akashgund/Handsfree-Computer-Assist/readme

This project is a IEEE accepted project.
The system was designed to help paralyzed computer and was accomplished with help of team work from along with two other colleagues -Bronson Mendonca and Siddhant Reddy
The material keyboard application was made with QT framework which is one the best ways to make cross platform applications.
The arduino code is designed for arduino leonardo.
