akashgund/Handsfree-Computer-Assist/Final report/BLACKBOOK1 (1).pdf

## PROJECT REPORT

ON

## COMPUTER ASSIST FOR PARALYZED USING EEG

SUBMITTED TO THE

## UNIVERSITY OF MUMBAI

FOR THE DEGREE OF

## BACHELOR OF ENGINEERING

IN

## COMPUTER ENGINEERING 2016-2017

Submitted by

Akash Gund (Roll No.24)

Bronson Mendonca (Roll No.45)

Siddhant Reddy (Roll No.58)

Supervisors:

Mrs. Kalpita Wagaskar

Mrs. Sejal Chopra

### DEPARTMENT OF COMPUTER ENGINEERING

DON BOSCO INSTITUTE OF TECHNOLOGY (ENGINEERING COLLEGE)
PREMIER AUTOMOBILES ROAD, KURLA (W) – 400070

## COMPUTER ASSIST FOR PARALYZED USING EEG

Submitted in partial fulfilment of the requirement for the Degree of

## BACHELOR OF ENGINEERING IN COMPUTER

## ENGINEERING

by

Akash Gund (Roll No.24)

Bronson Mendonca (Roll No.45)

Siddhant Reddy (Roll No.58)

Supervisors:

Mrs. Kalpita Wagaskar
Mrs. Sejal Chopra

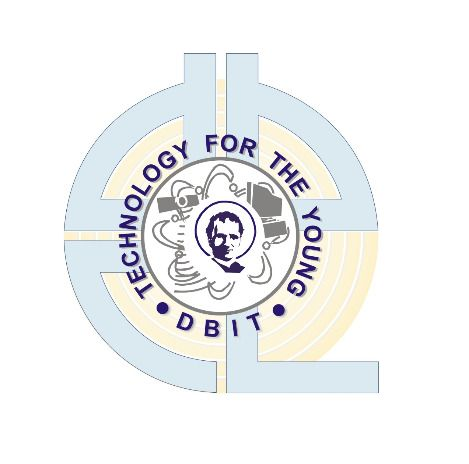
[picture p34: figure]

DEPARTMENT OF COMPUTER ENGINEERING

DON BOSCO INSTITUTE OF TECHNOLOGY (ENGINEERING COLLEGE) PREMIER AUTOMOBILES ROAD, KURLA (W) – 400070

2016-2017

## CERTIFICATE

This is to certify that the project report entitled “Computer Assist for Paralyzed
using EEG” | is a bonafide work of
1. | Akash Gund | B. E. – (Roll No. 25)
2. | Bronson Mendonca | B. E. – (Roll No. 45)
3. | Siddhant Reddy | B. E. – (Roll No. 58)

submitted to the University of Mumbai in partial fulfillment of the requirement for the award of the Degree of Bachelor of Engineering in the Computer Engineering

Kalpita Wagaskar | Sejal Chopra
Supervisor | Co-Supervisor
Ms. Nilakshi Joshi | Dr. P. Nambiar
Head of Department | Principal

Project Report Approval for B. E.

This project report entitled “Computer Assist for Paralyzed using EEG” by Akash Gund, Bronson Mendonca and Siddhant Reddy is approved for the degree of Computer Engineering course of Bachelor of Engineering.

Examiners
1.---------------------------------------------2.---------------------------------------------

Date:

Place:

## DECLARATION

I declare that this written submission represents my ideas in my own words and where others' ideas or words have been included, I have adequately cited and referenced the original sources. I also declare that I have adhered to all principles of academic honesty and integrity and have not misrepresented or fabricated or falsified any idea/data/fact/source in my submission. I understand that any violation of the above will be cause for disciplinary action by the Institute and can also evoke penal action from the sources which have thus not been properly cited or from whom proper permission has not been taken when needed.

1. | Akash Gund | (Roll No. 25)
(Name of student, Roll no.) | (Signature)
2. | Bronson Mendonca | (Roll No. 45)
(Name of student, Roll no.) | (Signature)
3. | Siddhant Reddy | (Roll No. 58)
(Name of student, Roll no.) | (Signature)

Date:

ABSTRACT

Computers have made life easier for the general population, however a technology is not fulfilling its purpose unless it is accessible by everyone. Namely the paralytics (hemiplegia, quadriplegia) who have a hard time with technology because it is designed for an average person. This is why we decided to make a hardware interface for desktop computers which would allow these patients to use a computer with ease. Various combination of non-invasive Brain-Computer interface have been promising in helping such patients by giving interactive solutions. A combination of 3 electrode EEG and an Arduino Leonardo, on basis of P300 waves which play crucial role in decision making process in brain will be used to make this hardware interface. This hardware interface aims to mimic a mouse and keyboard in operation and also its speed of use as much as possible for the concerned patient.

TABLE OF CONTENTS

Sr. No. | Contents | Page no.
- | ABSTRACT | i
- | CONTENTS | ii
- | LIST OF FIGURES | iv
- | ABBREVIATIONS | vii
Chapter 1 | Introduction | 1
| 1.1 Introduction | 1
| 1.2 Aims And Objectives | 2
| 1.3 Organization of report | 2
Chapter 2 | Literature Survey | 3
Chapter 3 | 3.1Problem Statement | 7
| 3.2 Scope | 7
Chapter 4 | Analysis And Design | 8
| 4.1 Existing System | 8
| 4.2 Proposed System | 8
| 4.3 System Plan | 10
| 4.4 Details Of Hardware And Software | 11
| 4.5 Design Details | 15

Chapter 5 | Implementation | 17
| 5.1 Module I - Hardware Mouse Emulation | 17
| 5.2 Module II - Software Virtual Keyboard | 20
Chapter 6 | System Operation | 26
| 6.1 Initialization | 26
| 6.2 Bluetooth Connection Setup | 27
| 6.3 System setup | 29
Chapter 7 | Results and Testing | 30
Chapter 8 | Project timeline and task distribution | 34
| Conclusion | 35
| References | 36
| Appendix | 39
| Source Code | 40
| Acknowledgement | 57

LIST OF FIGURES

Figure No. | Name | Page No.
2.1 | Tilvus Program | 4
2.2 | International Morse Code Letters and Numerals | 5
3.1 | System Architecture | 9
4.1 | Arduino Leonardo | 11
4.2 | Mindwave EEG Headset | 12
4.3 | HC-05 Bluetooth Module | 13
4.4 | Accelerometer Module | 13
4.5 | System Design | 15
5.1 | Arduino circuit with casing | 18
5.2 | Nokia 3310 using the 9 key layout | 21
5.3 | Complete Keyboard Layout | 22
5.4 | Default State of Keyboard | 22
5.5 | Expanded State of Keyboard | 23
5.6 | Symbol Entry Mode | 24
5.7 | Number Entry Mode | 24

5.8 | Prediction Area | 25
7.1 | Setting up the system | 31
7.2 | First Test of the system on Dr. Faizal | 31
7.3 | Dr. Faizal typing words using keyboard application | 32
7.4 | Graph Depicting clicks that were detected | 33
8.1 | Timeline | 34

ABBREVIATIONS

EEG | ElectroEncephaloGram
AI | Artificial Intelligence
GUI | Graphical User Interface
IP | Image Processing
