akashgund/Handsfree-Computer-Assist/poster (3).png

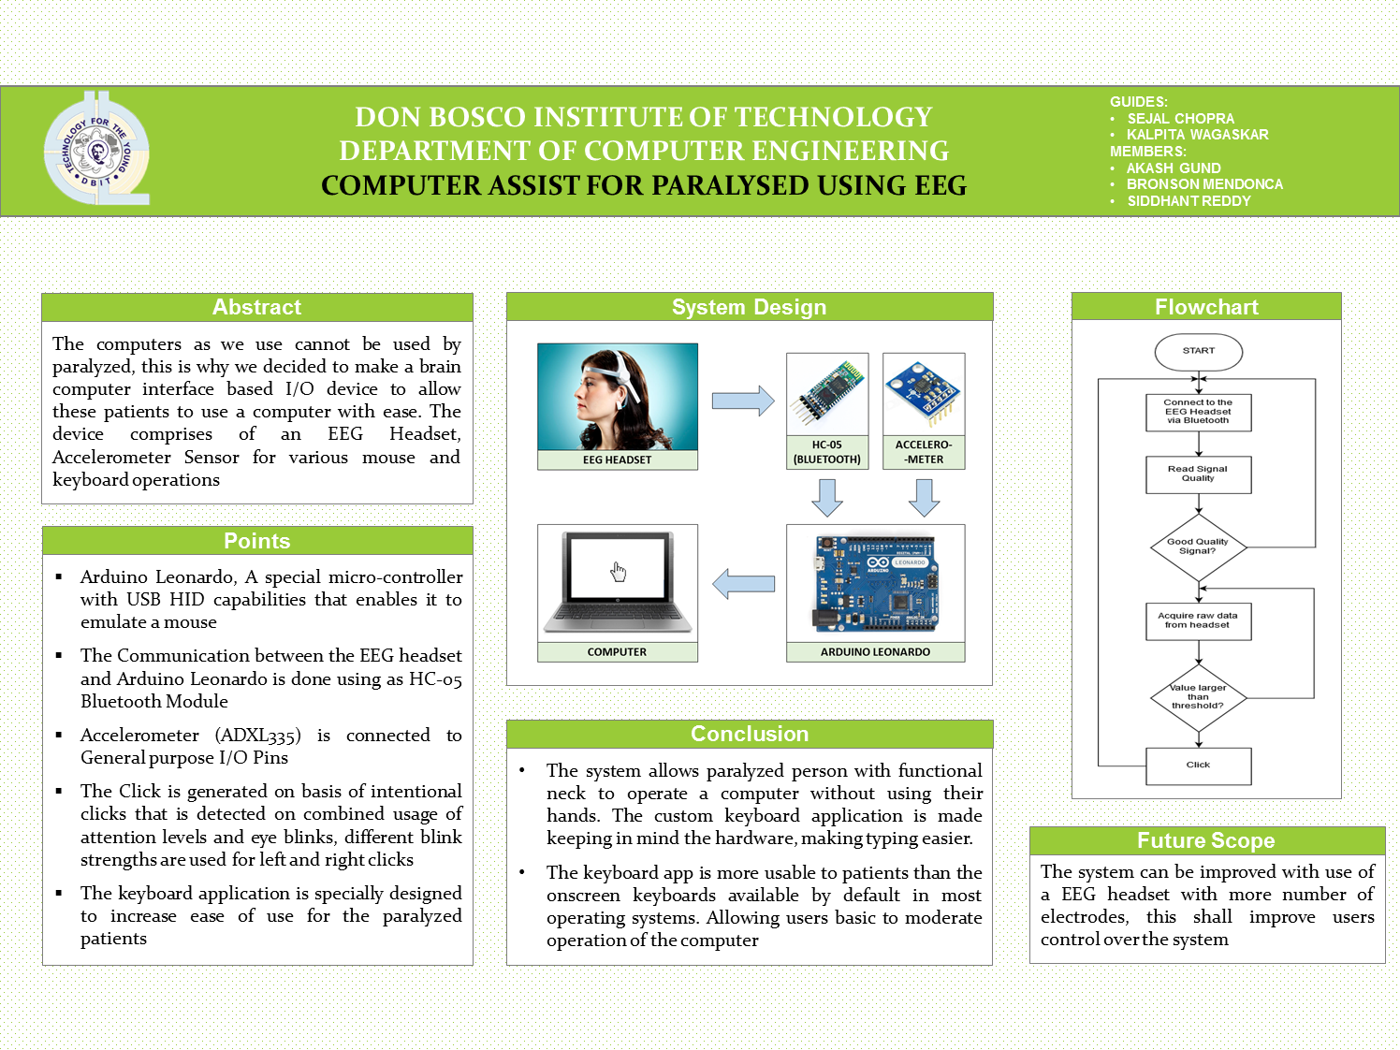
poster (3).png
